986-Studio/FelinaePurr/doc/FelinaePurr_1.0.png

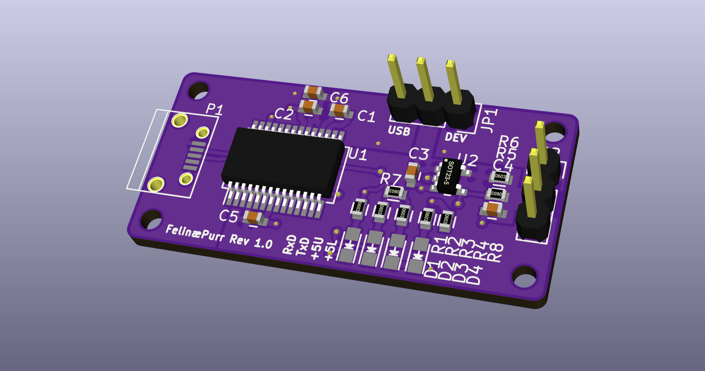
doc/FelinaePurr_1.0.png
