986-Studio/FelinaePurr/doc/FelinaePurr_1.1A.png

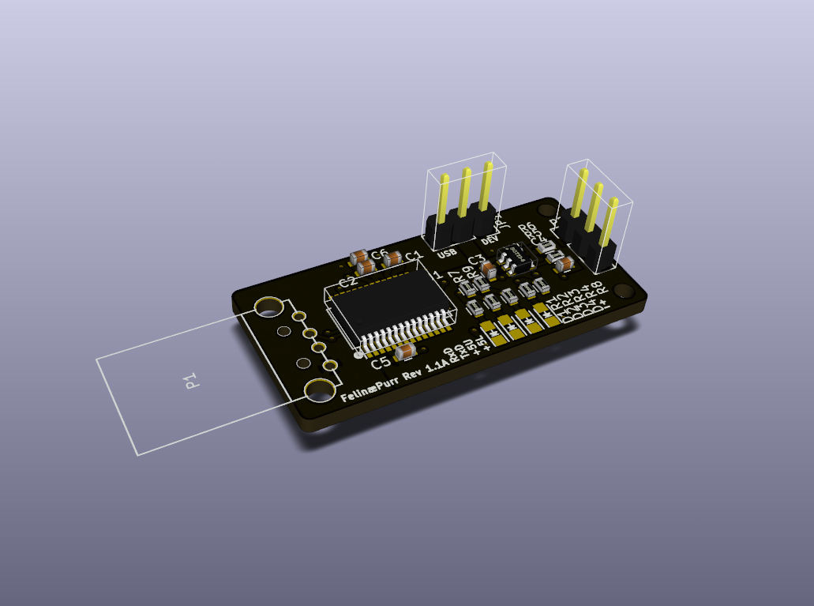
doc/FelinaePurr_1.1A.png
