986-Studio/FelinaePurr/(commit log)

2016-07-15 Add Rev1.0 and Readme file
    [FelinaePurr-B.Cu.gbl, FelinaePurr-B.Mask.gbs, FelinaePurr-B.SilkS.gbo, FelinaePurr-Edge.Cuts.gm1, FelinaePurr-F.Cu.gtl, FelinaePurr-F.Mask.gts, FelinaePurr-F.SilkS.gto, FelinaePurr.drl]
2016-07-15 Update R on D2/D4 to use two 100Ω R and add value for D1/D2 R
    [FelinaePurr.kicad_pcb, FelinaePurr.sch]
2016-07-15 Add mounting hole that had disappeared
    [FelinaePurr-B.Cu.gbl, FelinaePurr-B.Mask.gbs, FelinaePurr-B.SilkS.gbo, FelinaePurr-Edge.Cuts.gm1, FelinaePurr-F.Cu.gtl, FelinaePurr-F.Mask.gts, FelinaePurr-F.SilkS.gto, FelinaePurr.drl]
2016-07-15 moved a bit USB port to be a bit outside of the PCB. Update illustration picture and update OSHPark link
    [FelinaePurr-B.Cu.gbl, FelinaePurr-B.Mask.gbs, FelinaePurr-B.SilkS.gbo, FelinaePurr-Edge.Cuts.gm1, FelinaePurr-F.Cu.gtl, FelinaePurr-F.Mask.gts, FelinaePurr-F.SilkS.gto, FelinaePurr.drl]
2016-07-16 Small kicad changes
    [FelinaePurr.kicad_pcb]
2017-04-23 Correct a stupid error on U2 and add 100Ω more to the blue led which is clearly too bright
    [FelinaePurr.kicad_pcb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]
2017-04-23 Add missing holes, and change 'board#' layout, update revision to 1.1
    [FelinaePurr.kicad_pcb, FelinaePurr.sch]
2017-04-23 USB-A Version
    [FelinaePurr-B.Cu.gbl, FelinaePurr-B.Mask.gbs, FelinaePurr-B.SilkS.gbo, FelinaePurr-Edge.Cuts.gm1, FelinaePurr-F.Cu.gtl, FelinaePurr-F.Mask.gts, FelinaePurr-F.SilkS.gto, FelinaePurr.drl]
2017-04-23 Another stupid mistake corrected..
    [FelinaePurr-B.Cu.gbl, FelinaePurr-B.Mask.gbs, FelinaePurr-B.SilkS.gbo, FelinaePurr-Edge.Cuts.gm1, FelinaePurr-F.Cu.gtl, FelinaePurr-F.Mask.gts, FelinaePurr-F.Paste.gtp, FelinaePurr-F.SilkS.gto]
2017-04-23 I hate you kicad to delete components which are not part of the schematics
    [FelinaePurr-B.Cu.gbl, FelinaePurr-B.Mask.gbs, FelinaePurr-B.SilkS.gbo, FelinaePurr-Edge.Cuts.gm1, FelinaePurr-F.Cu.gtl, FelinaePurr-F.Mask.gts, FelinaePurr-F.Paste.gtp, FelinaePurr-F.SilkS.gto]
2017-04-23 Update ©
    [FelinaePurr-B.Cu.gbl, FelinaePurr-B.Mask.gbs, FelinaePurr-B.SilkS.gbo, FelinaePurr-Edge.Cuts.gm1, FelinaePurr-F.Cu.gtl, FelinaePurr-F.Mask.gts, FelinaePurr-F.Paste.gtp, FelinaePurr-F.SilkS.gto]
2017-08-04 Update USB A pads to have larger rings
    [FelinaePurr-B.Cu.gbl, FelinaePurr-B.Mask.gbs, FelinaePurr-B.SilkS.gbo, FelinaePurr-Edge.Cuts.gm1, FelinaePurr-F.Cu.gtl, FelinaePurr-F.Mask.gts, FelinaePurr-F.SilkS.gto, FelinaePurr.drl]
2017-08-08 Add 2.5 jack
    [FelinaePurr-B.Cu.gbl, FelinaePurr-B.Mask.gbs, FelinaePurr-B.SilkS.gbo, FelinaePurr-Edge.Cuts.gm1, FelinaePurr-F.Cu.gtl, FelinaePurr-F.Mask.gts, FelinaePurr-F.Paste.gtp, FelinaePurr-F.SilkS.gto]
2017-08-08 Update rev to 1.2
    [FelinaePurr-B.Cu.gbl, FelinaePurr-B.Mask.gbs, FelinaePurr-B.SilkS.gbo, FelinaePurr-Edge.Cuts.gm1, FelinaePurr-F.Cu.gtl, FelinaePurr-F.Mask.gts, FelinaePurr-F.Paste.gtp, FelinaePurr-F.SilkS.gto]
2017-08-10 For some unknown reason no SMT pad had it's paste layer set..
    [FelinaePurr-B.Cu.gbl, FelinaePurr-B.Mask.gbs, FelinaePurr-B.SilkS.gbo, FelinaePurr-Edge.Cuts.gm1, FelinaePurr-F.Cu.gtl, FelinaePurr-F.Mask.gts, FelinaePurr-F.Paste.gtp, FelinaePurr-F.SilkS.gto]
