986-Studio/FelinaePurr/(notices)

Notices in the files:
FelinaePurr.kicad_pcb:
© 2017 986-Studio
